potpurri/stepper-driver-thing-test-board/Stupid-stepper.kicad_pcb

## KiCad design Stupid-stepper.kicad_pcb (2026-04-08)

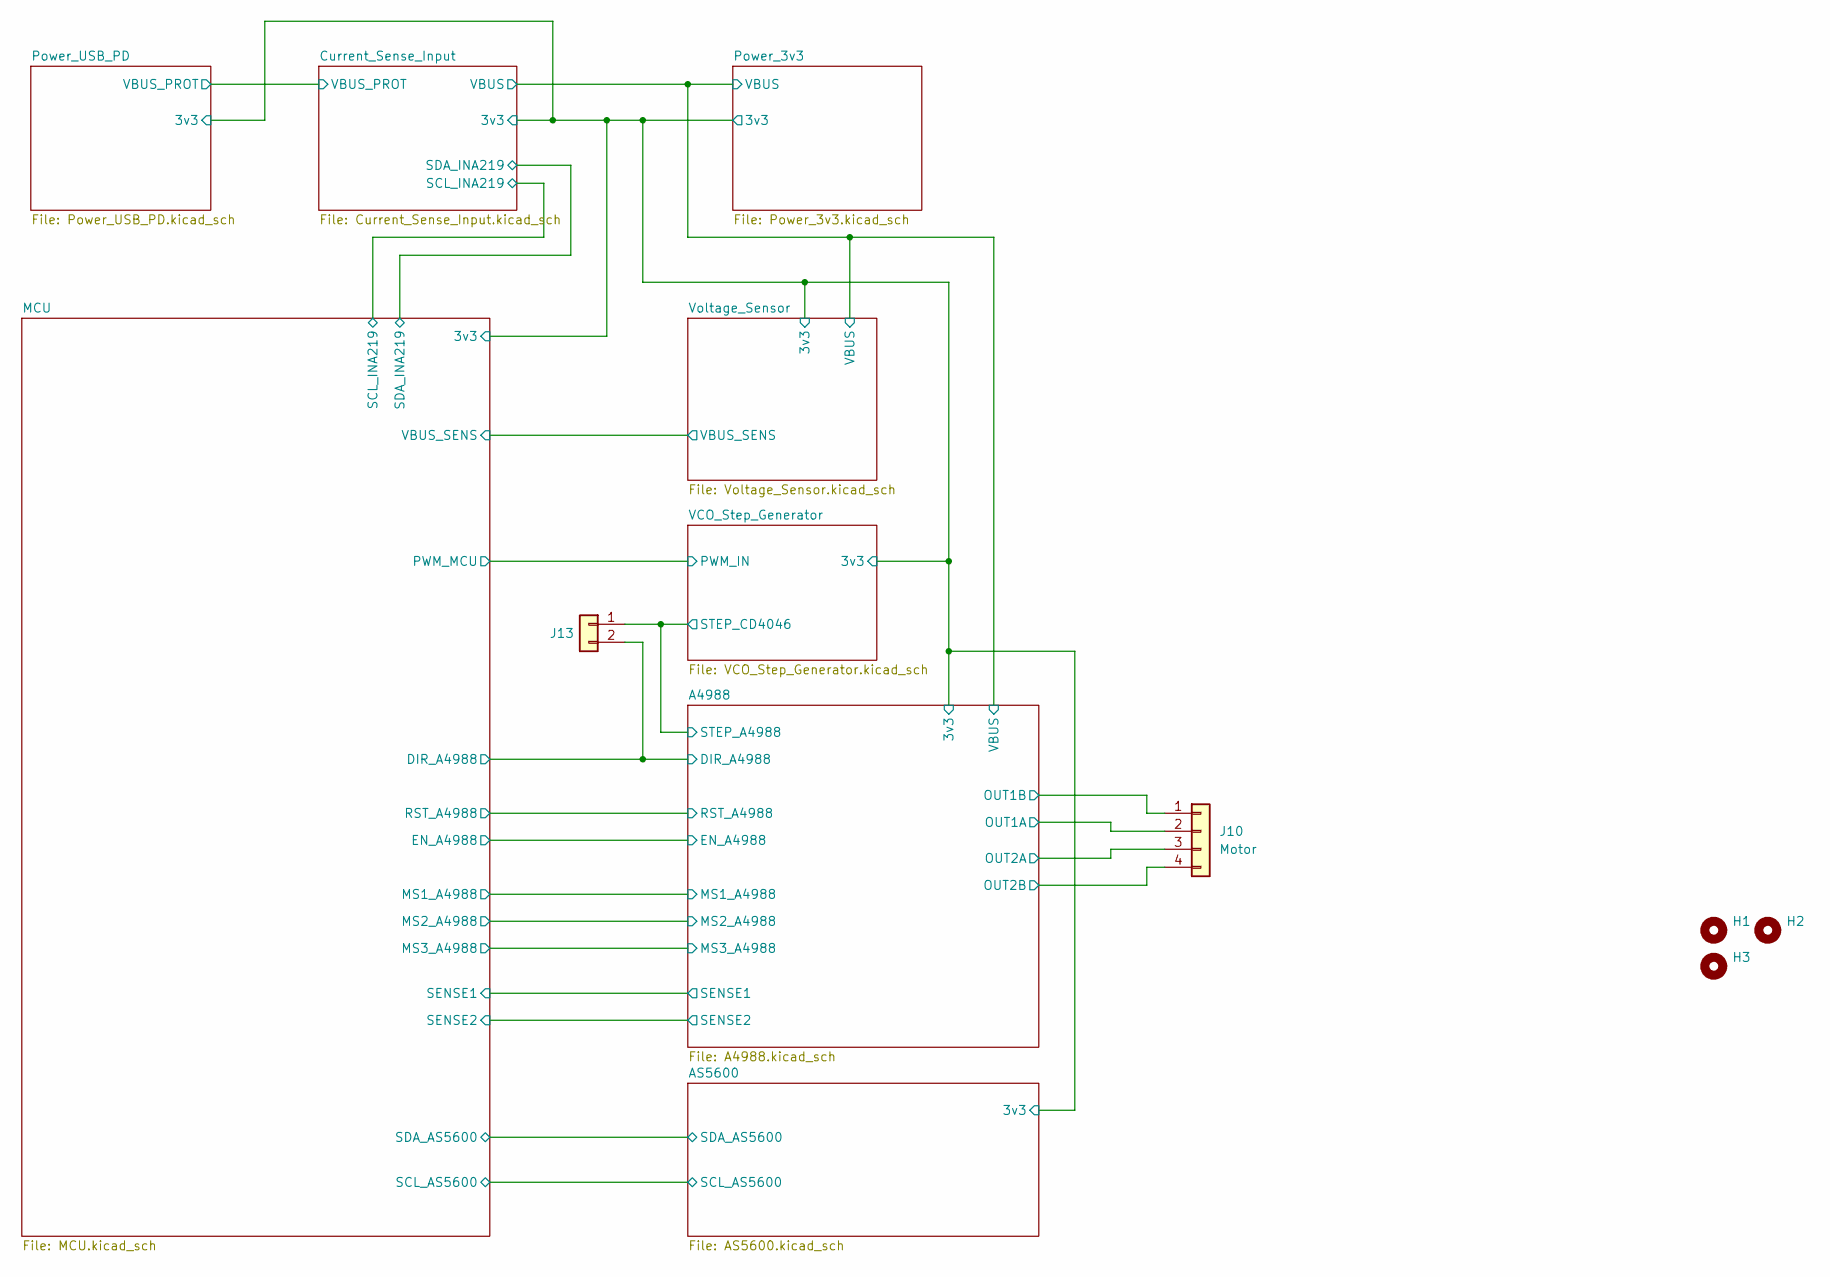
[picture p1: schematic Stupid-stepper.kicad_sch]

Parts:
H1, H2, H3: MountingHole; MountingHole_3.2mm_M3_DIN965_Pad_TopBottom
J10: Motor; JST_PH_B4B-PH-K_1x04_P2.00mm_Vertical
J13: Conn_01x02; PinHeader_1x02_P2.54mm_Vertical

Connections:
/A4988/DIR_A4988: J13.2; also elsewhere on the board
/A4988/OUT1A: J10.2; also elsewhere on the board
/A4988/OUT1B: J10.1; also elsewhere on the board
/A4988/OUT2A: J10.3; also elsewhere on the board
/A4988/OUT2B: J10.4; also elsewhere on the board
/A4988/STEP_A4988: J13.1; also elsewhere on the board

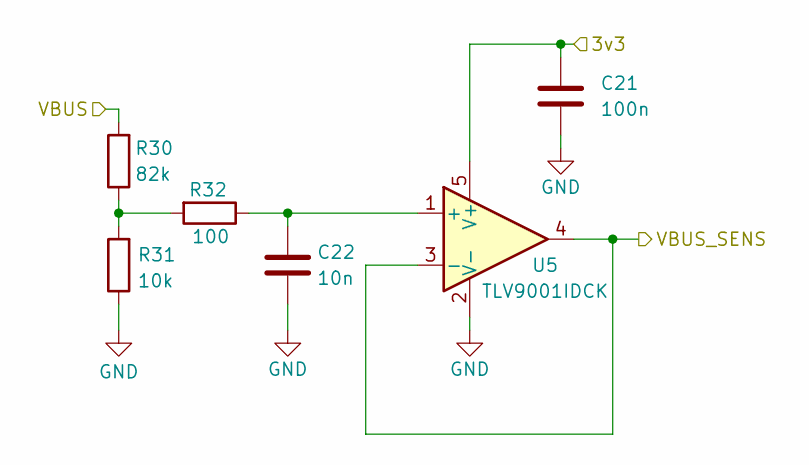
[picture p2: schematic Voltage_Sensor.kicad_sch]

Parts:
C21: 100n; C_0603_1608Metric
C22: 10n; C_0603_1608Metric
R30: 82k; R_0603_1608Metric
R31: 10k; R_0603_1608Metric
R32: 100; R_0603_1608Metric
U5: TLV9001IDCK; SOT-353_SC-70-5

Connections:
+3.3V: C21.1, U5.5 (V+); also elsewhere on the board
/MCU/VBUS_SENS: U5.3 (-), U5.4; also elsewhere on the board
GND: C21.2, C22.2, R31.1, U5.2 (V-); also elsewhere on the board
unnamed: R30.1, R31.2, R32.2
unnamed: C22.1, R32.1, U5.1 (+)
VBUS: R30.2; also elsewhere on the board

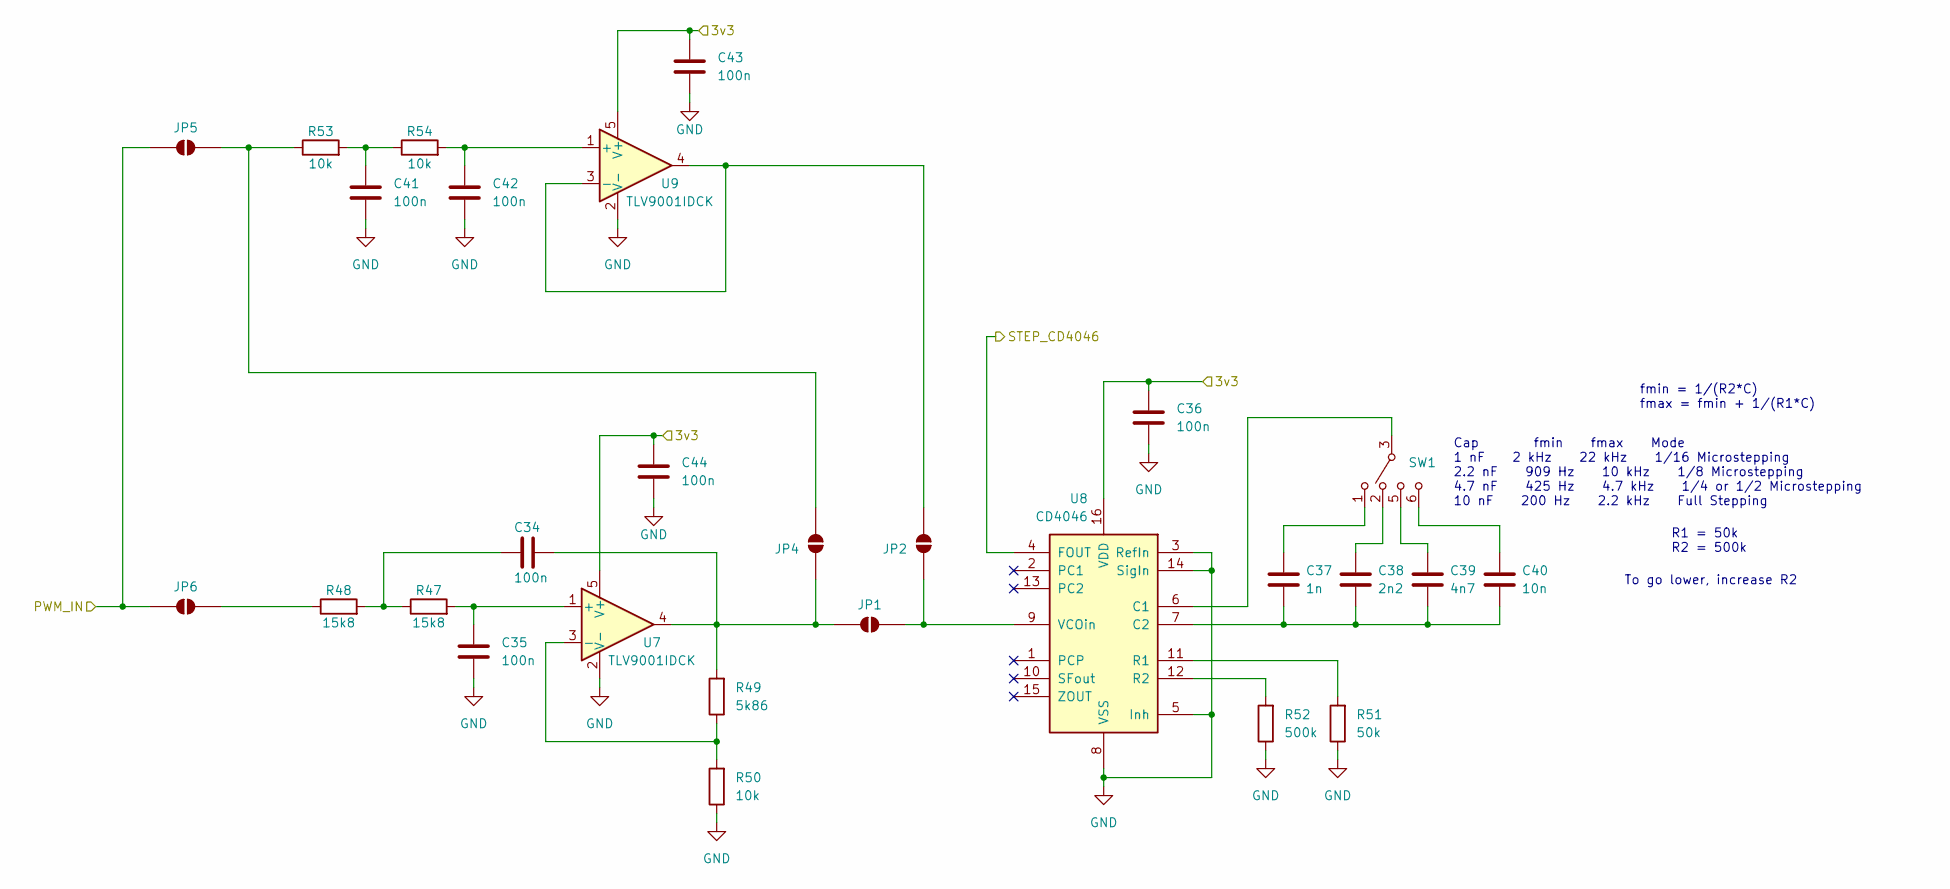
[picture p3: schematic VCO_Step_Generator.kicad_sch]

Parts:
C34, C35, C36, C41, C42, C43, C44: 100n; C_0603_1608Metric
C37: 1n; C_0603_1608Metric
C38: 2n2; C_0603_1608Metric
C39: 4n7; C_0603_1608Metric
C40: 10n; C_0603_1608Metric
JP1, JP2, JP4, JP5, JP6: SolderJumper_2_Open; SolderJumper-2_P1.3mm_Open_RoundedPad1.0x1.5mm
R47, R48: 15k8; R_0603_1608Metric
R49: 5k86; R_0603_1608Metric
R50, R53, R54: 10k; R_0603_1608Metric
R51: 50k; R_0603_1608Metric
R52: 500k; R_0603_1608Metric
SW1: mskt-14c01
U7, U9: TLV9001IDCK; SOT-353_SC-70-5
U8: CD4046; TSSOP-16_4.4x5mm_P0.65mm

Connections:
+3.3V: C36.1, C43.1, C44.1, U7.5 (V+), U8.16 (VDD), U9.5 (V+); also elsewhere on the board
/A4988/STEP_A4988: U8.4 (FOUT); also elsewhere on the board
/MCU/PWM_MCU: JP5.1 (A), JP6.1 (A); also elsewhere on the board
GND: C35.2, C36.2, C41.2, C42.2, C43.2, C44.2, R50.1, R51.1, R52.1, U7.2 (V-), U8.3 (RefIn), U8.5 (Inh), U8.8 (VSS), U8.14 (SigIn), U9.2 (V-); also elsewhere on the board
unnamed: C34.2, R47.1, R48.2
unnamed: C37.1, SW1.1
unnamed: C38.1, SW1.2
unnamed: C39.1, SW1.5
unnamed: C40.1, SW1.6
unnamed: C41.1, R53.2, R54.1
unnamed: C34.1, JP1.1 (A), JP4.2 (B), R49.2, U7.4
unnamed: JP1.2 (B), JP2.2 (B), U8.9 (VCOin)
unnamed: JP2.1 (A), U9.3 (-), U9.4
unnamed: JP4.1 (A), JP5.2 (B), R53.1
unnamed: JP6.2 (B), R48.1
unnamed: C35.1, R47.2, U7.1 (+)
unnamed: R49.1, R50.2, U7.3 (-)
unnamed: SW1.3, SW1.4, U8.6 (C1)
unnamed: C37.2, C38.2, C39.2, C40.2, U8.7 (C2)
unnamed: R51.2, U8.11 (R1)
unnamed: R52.2, U8.12 (R2)
unnamed: C42.1, R54.2, U9.1 (+)

Notes on the sheet:
R1 = 50k R2 = 500k
fmin = 1/(R2*C) fmax = fmin + 1/(R1*C)
To go lower, increase R2
Cap fmin fmax Mode 1 nF 2 kHz 22 kHz 1/16 Microstepping 2.2 nF 909 Hz 10 kHz 1/8 Microstepping 4.7 nF 425 Hz 4.7 kHz 1/4 or 1/2 Microstepping 10 nF 200 Hz 2.2 kHz Full Stepping

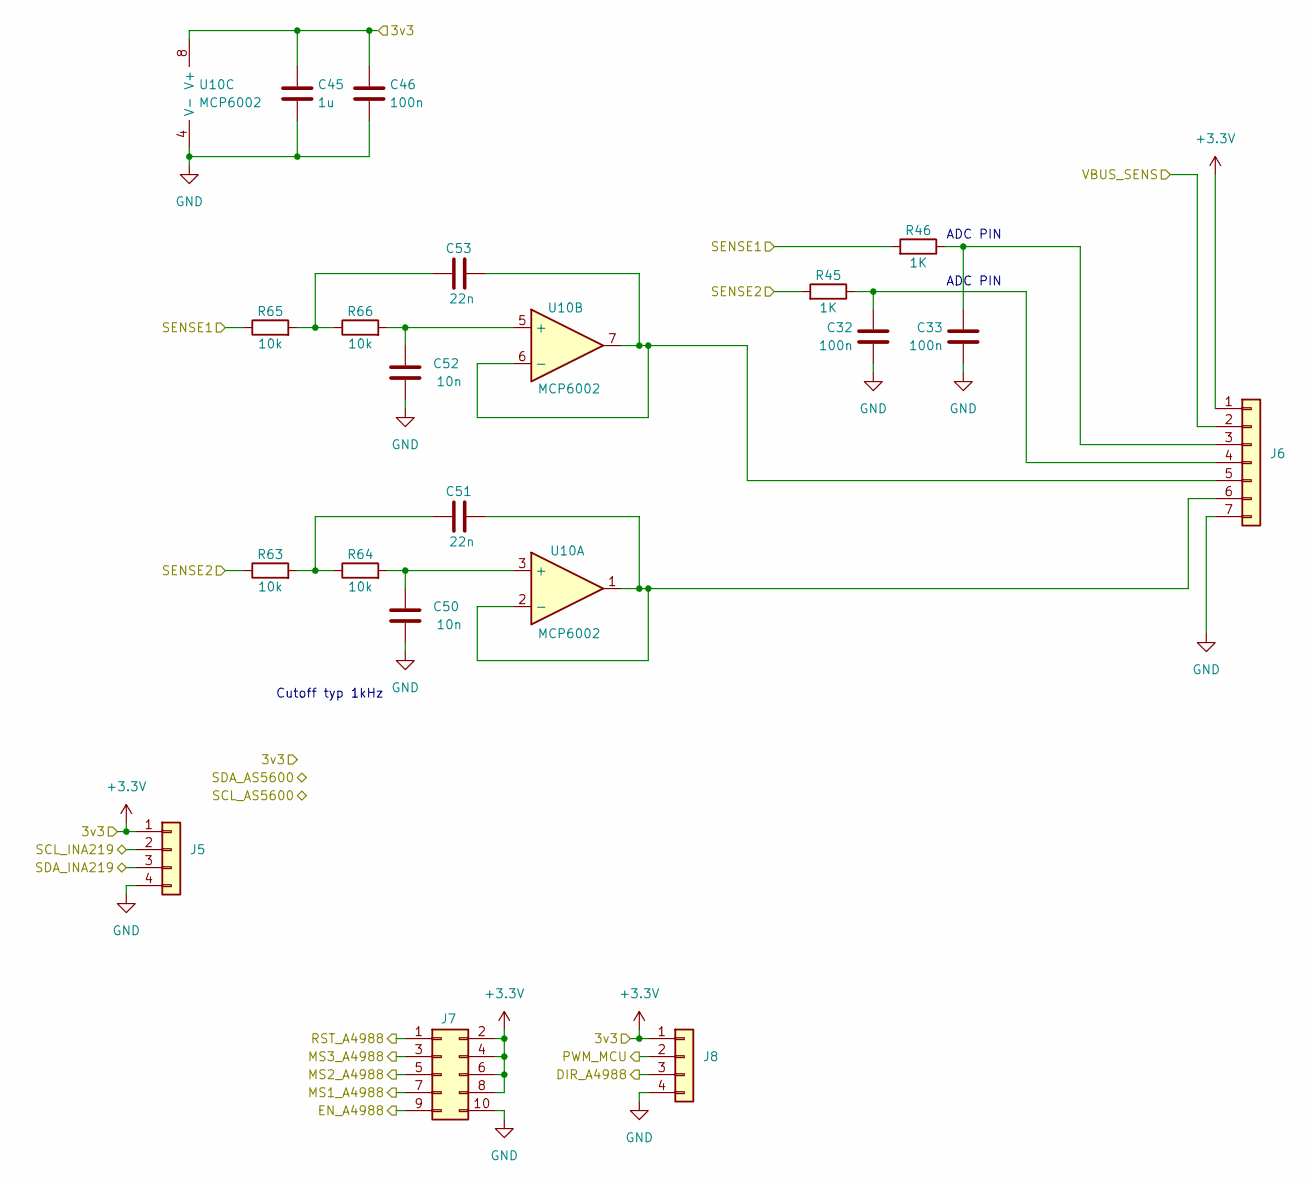
[picture p4: schematic MCU.kicad_sch]

Parts:
C32, C33, C46: 100n; C_0603_1608Metric
C45: 1u; C_0603_1608Metric
C50, C52: 10n; C_0603_1608Metric
C51, C53: 22n; C_0603_1608Metric
J5, J8: Conn_01x04; PinHeader_1x04_P2.54mm_Vertical
J6: Conn_01x07; PinHeader_1x07_P2.54mm_Vertical
J7: Conn_02x05_Odd_Even; PinHeader_2x05_P2.54mm_Vertical
R45, R46: 1K; R_0603_1608Metric
R63, R64, R65, R66: 10k; R_0603_1608Metric
U10:  MCP6002; SOIC-8_3.9x4.9mm_P1.27mm

Connections:
+3.3V: C45.1, C46.1, J5.1, J6.1, J7.2, J7.4, J7.6, J7.8, J8.1, U10.8 (V+); also elsewhere on the board
/A4988/DIR_A4988: J8.3; also elsewhere on the board
/A4988/EN_A4988: J7.9; also elsewhere on the board
/A4988/MS1_A4988: J7.7; also elsewhere on the board
/A4988/MS2_A4988: J7.5; also elsewhere on the board
/A4988/MS3_A4988: J7.3; also elsewhere on the board
/A4988/RST_A4988: J7.1; also elsewhere on the board
/A4988/SENSE1: R46.2, R65.1; also elsewhere on the board
/A4988/SENSE2: R45.2, R63.1; also elsewhere on the board
/Current_Sense_Input/SCL_INA219: J5.2; also elsewhere on the board
/Current_Sense_Input/SDA_INA219: J5.3; also elsewhere on the board
/MCU/PWM_MCU: J8.2; also elsewhere on the board
/MCU/VBUS_SENS: J6.2; also elsewhere on the board
GND: C32.2, C33.2, C45.2, C46.2, C50.2, C52.2, J5.4, J6.7, J7.10, J8.4, U10.4 (V-); also elsewhere on the board
unnamed: C51.2, R63.2, R64.1
unnamed: C53.2, R65.2, R66.1
unnamed: C33.1, J6.3, R46.1
unnamed: C32.1, J6.4, R45.1
unnamed: C53.1, J6.5, U10.6 (-), U10.7
unnamed: C51.1, J6.6, U10.1, U10.2 (-)
unnamed: C50.1, R64.2, U10.3 (+)
unnamed: C52.1, R66.2, U10.5 (+)

Notes on the sheet:
ADC PIN
Cutoff typ 1kHz

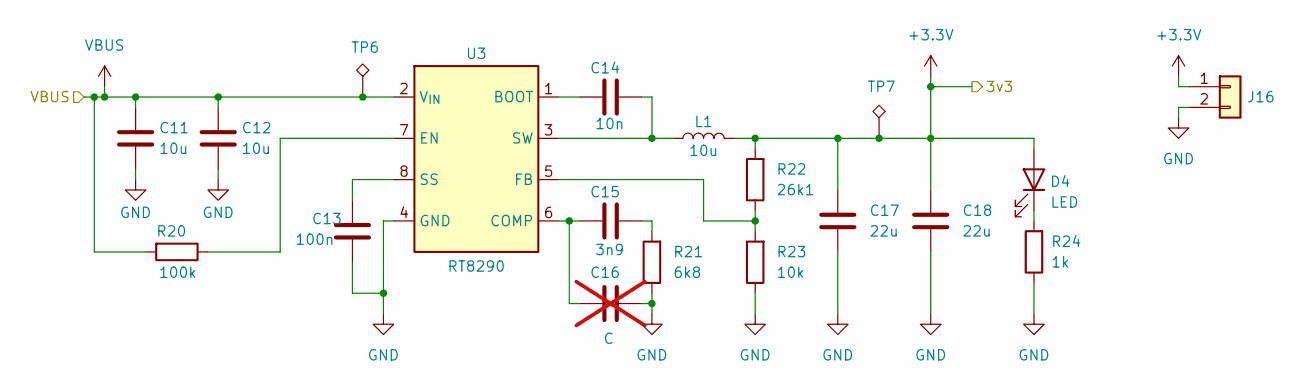
[picture p5: schematic Power_3v3.kicad_sch]

Parts:
C11, C12: 10u; C_1206_3216Metric
C13: 100n; C_0603_1608Metric
C14: 10n; C_0603_1608Metric
C15: 3n9; C_0603_1608Metric
C16: C; C_0603_1608Metric; not fitted
C17, C18: 22u; C_1206_3216Metric
D4: LED; LED_0805_2012Metric
J16: Conn_01x02; PinHeader_1x02_P2.54mm_Vertical
L1: 10u; L_APV_ANR5020
R20: 100k; R_0603_1608Metric
R21: 6k8; R_0603_1608Metric
R22: 26k1; R_0603_1608Metric
R23: 10k; R_0603_1608Metric
R24: 1k; R_0603_1608Metric
TP6, TP7: TestPoint_Alt; TestPoint_Pad_D1.0mm
U3: RT8290; Texas_HSOP-8-1EP_3.9x4.9mm_P1.27mm

Connections:
+3.3V: C17.1, C18.1, D4.2 (A), J16.1, L1.2, R22.2, TP7.1 (1_1); also elsewhere on the board
GND: C11.2, C12.2, C13.2, C16.2, C17.2, C18.2, J16.2, R21.1, R23.1, R24.1, U3.4 (GND), U3.9 (GND); also elsewhere on the board
unnamed: C15.2, R21.2
unnamed: D4.1 (K), R24.2
unnamed: C14.1, U3.1 (BOOT)
unnamed: C15.1, C16.1, U3.6 (COMP)
unnamed: R20.1, U3.7 (EN)
unnamed: R22.1, R23.2, U3.5 (FB)
unnamed: C13.1, U3.8 (SS)
unnamed: C14.2, L1.1, U3.3 (SW)
VBUS: C11.1, C12.1, R20.2, TP6.1 (1_1), U3.2 (V_{IN}); also elsewhere on the board

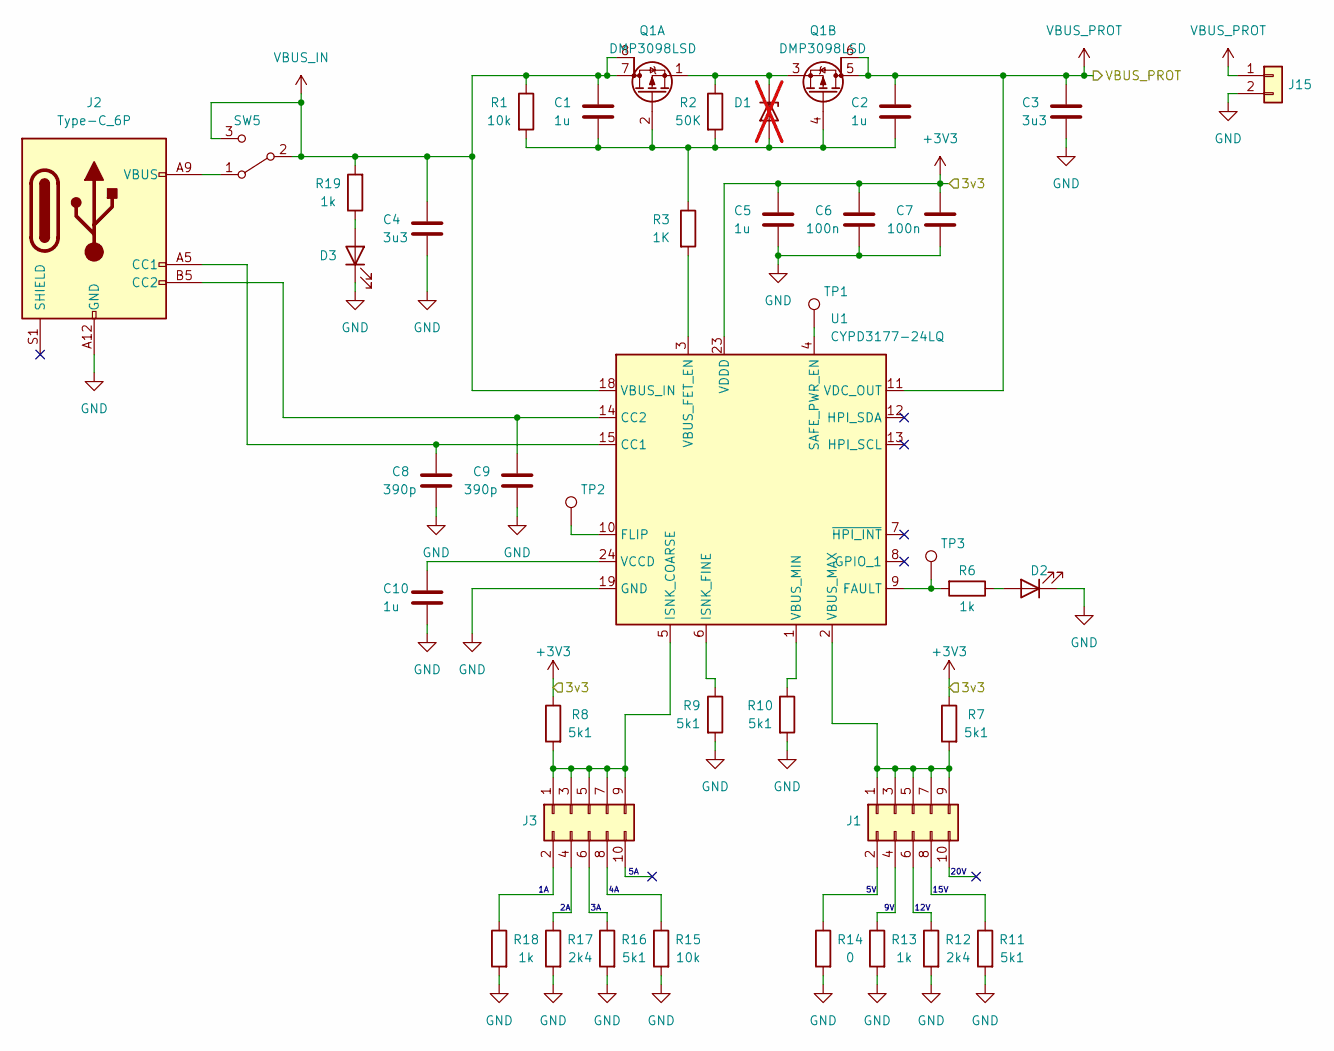
[picture p6: schematic Power_USB_PD.kicad_sch]

Parts:
C1, C2, C5, C10: 1u; C_0805_2012Metric_Pad1.18x1.45mm_HandSolder
C3, C4: 3u3; C_0805_2012Metric_Pad1.18x1.45mm_HandSolder
C6, C7: 100n; C_0603_1608Metric_Pad1.08x0.95mm_HandSolder
C8, C9: 390p; C_0603_1608Metric_Pad1.08x0.95mm_HandSolder
D1: D_Zener; D_DO-35_SOD27_P7.62mm_Horizontal; not fitted
D2, D3: LED; LED_0805_2012Metric
J1, J3: Conn_02x05_Odd_Even; PinHeader_2x05_P2.54mm_Vertical
J2: Type-C_6P; USB_C_Receptacle_HRO_TYPE-C-31-M-17
J15: Conn_01x02; PinHeader_1x02_P2.54mm_Vertical
Q1: DMP3098LSD; SOIC-8-1EP_3.9x4.9mm_P1.27mm_EP2.29x3mm
R1, R15: 10k; R_0603_1608Metric
R2: 50K; R_0603_1608Metric
R3: 1K; R_0603_1608Metric
R6, R13, R18, R19: 1k; R_0603_1608Metric
R7, R8, R9, R10, R11, R16: 5k1; R_0603_1608Metric
R12, R17: 2k4; R_0603_1608Metric
R14: 0; R_0603_1608Metric
SW5: SW_SPDT; Schiebeschalter SS-12D00
TP1, TP2, TP3: TestPoint; TestPoint_Pad_1.0x1.0mm
U1: CYPD3177-24LQ; QFN-24-1EP_4x4mm_P0.5mm_EP2.75x2.75mm_ThermalVias

Connections:
+3.3V: C5.1, C6.1, C7.1, R7.1, R8.1, U1.23 (VDDD); also elsewhere on the board
GND: C3.2, C4.2, C5.2, C6.2, C7.2, C8.2, C9.2, C10.2, D2.1 (K), D3.1 (K), J2.A12 (GND), J2.B12 (GND), J15.2, R9.2, R10.2, R11.2, R12.2, R13.2, R14.2, R15.2, R16.2, R17.2, R18.2, U1.19 (GND), U1.22 (GND), U1.25 (GND); also elsewhere on the board
unnamed: C1.2, C2.2, D1.2 (A), Q1.2 (G), Q1.4 (G), R1.2, R2.2, R3.1
unnamed: D1.1 (K), Q1.1 (S), Q1.3 (S), R2.1
unnamed: D2.2 (A), R6.1
unnamed: D3.2 (A), R19.1
unnamed: J1.1, J1.3, J1.5, J1.7, J1.9, R7.2, U1.2 (VBUS_MAX)
unnamed: J1.2, R14.1
unnamed: J1.4, R13.1
unnamed: J1.6, R12.1
unnamed: J1.8, R11.1
unnamed: C8.1, J2.A5 (CC1), U1.15 (CC1)
unnamed: C9.1, J2.B5 (CC2), U1.14 (CC2)
unnamed: J3.1, J3.3, J3.5, J3.7, J3.9, R8.2, U1.5 (ISNK_COARSE)
unnamed: J3.2, R18.1
unnamed: J3.4, R17.1
unnamed: J3.6, R16.1
unnamed: J3.8, R15.1
unnamed: J2.A9 (VBUS), J2.B9 (VBUS), SW5.1 (A)
unnamed: R6.2, TP3.1 (1_1), U1.9 (FAULT)
unnamed: TP2.1 (1_1), U1.10 (FLIP)
unnamed: R9.1, U1.6 (ISNK_FINE)
unnamed: TP1.1 (1_1), U1.4 (SAFE_PWR_EN)
unnamed: R3.2, U1.3 (VBUS_FET_EN)
unnamed: R10.1, U1.1 (VBUS_MIN)
unnamed: C10.1, U1.24 (VCCD)
VBUS_IN: C1.1, C4.1, Q1.7 (D), Q1.8 (G), R1.1, R19.2, SW5.2 (B), SW5.3 (C), U1.18 (VBUS_IN)
VBUS_PROT: C2.1, C3.1, J15.1, Q1.5 (D), Q1.6 (G), U1.11 (VDC_OUT); also elsewhere on the board

Notes on the sheet:
15V
20V
12V

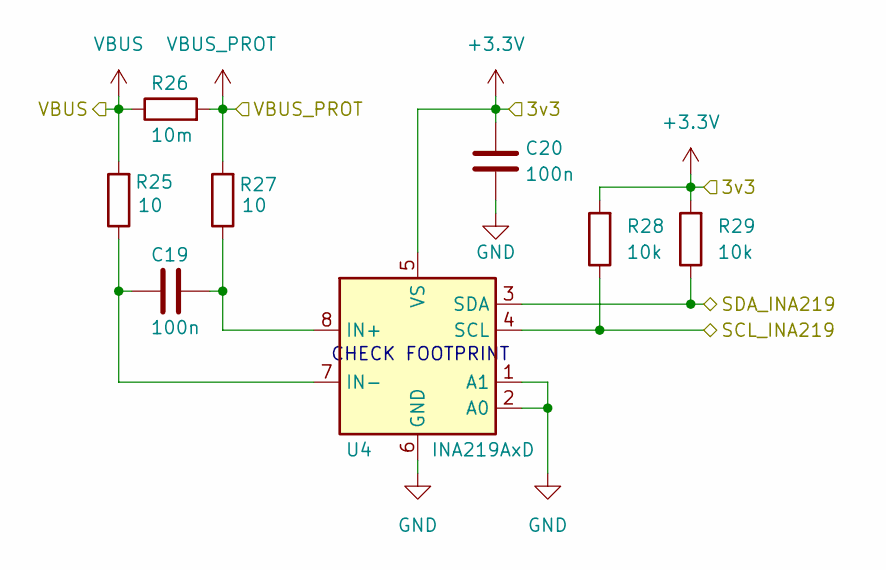
[picture p7: schematic Current_Sense_Input.kicad_sch]

Parts:
C19, C20: 100n; C_0603_1608Metric
R25, R27: 10; R_0603_1608Metric
R26: 10m; R_2512_6332Metric
R28, R29: 10k; R_0603_1608Metric
U4: INA219AxD; SOIC-8_3.9x4.9mm_P1.27mm

Connections:
+3.3V: C20.1, R28.2, R29.2, U4.5 (VS); also elsewhere on the board
/Current_Sense_Input/SCL_INA219: R28.1, U4.4 (SCL); also elsewhere on the board
/Current_Sense_Input/SDA_INA219: R29.1, U4.3 (SDA); also elsewhere on the board
GND: C20.2, U4.1 (A1), U4.2 (A0), U4.6 (GND); also elsewhere on the board
unnamed: C19.1, R27.1, U4.8 (IN+)
unnamed: C19.2, R25.1, U4.7 (IN-)
VBUS: R25.2, R26.1; also elsewhere on the board
VBUS_PROT: R26.2, R27.2; also elsewhere on the board

Notes on the sheet:
CHECK FOOTPRINT

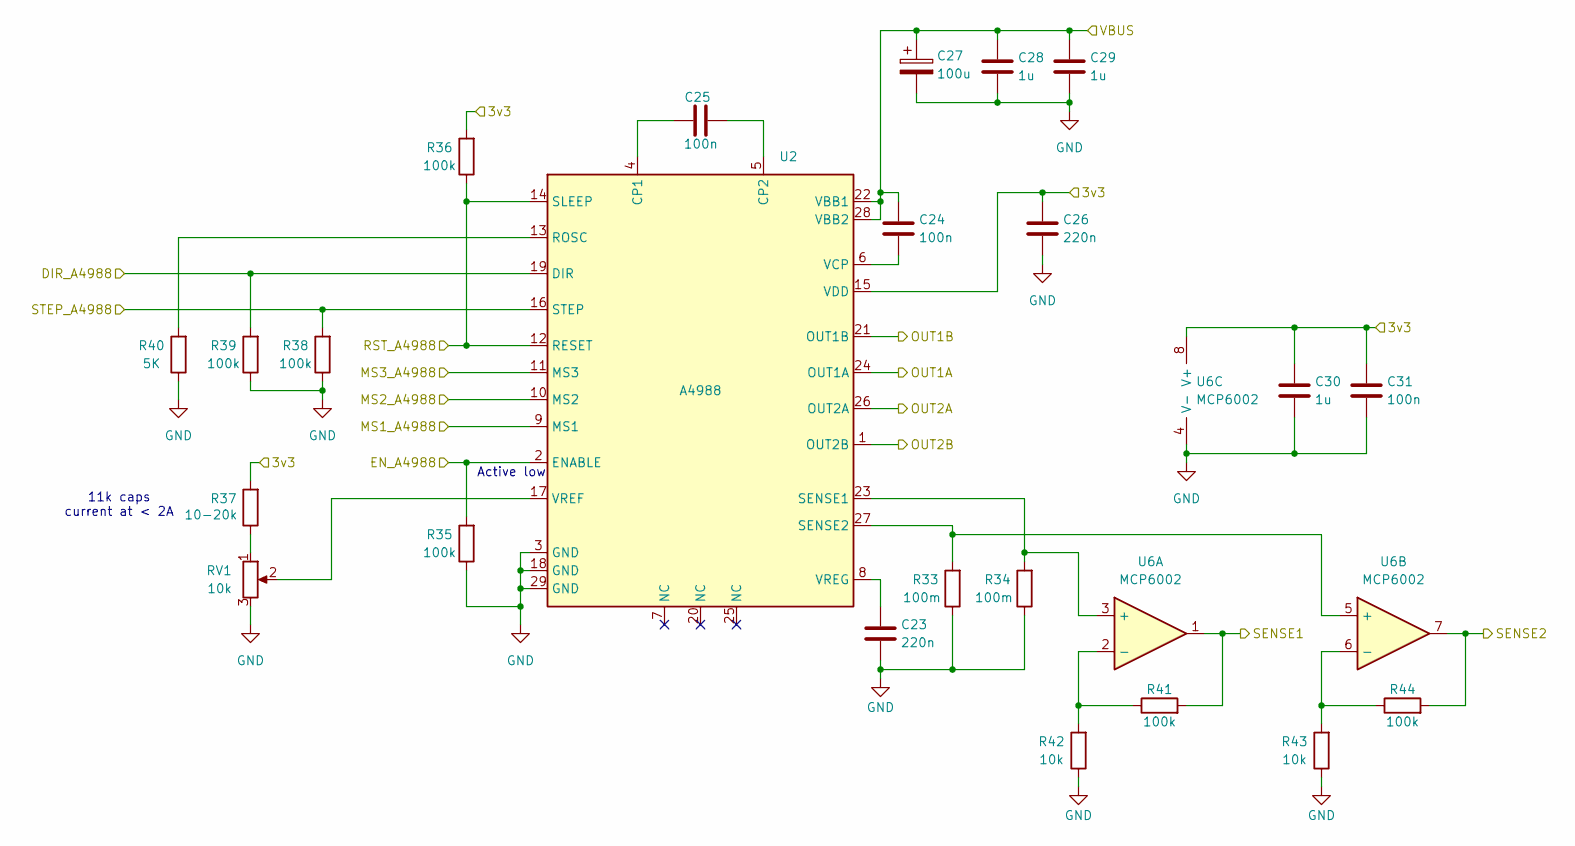
[picture p8: schematic A4988.kicad_sch]

Parts:
C23, C26: 220n; C_0603_1608Metric
C24, C25, C31: 100n; C_0603_1608Metric
C27: 100u; CP_Elec_8x10.5
C28, C29, C30: 1u; C_0603_1608Metric
R33, R34: 100m; R_1206_3216Metric
R35, R36, R38, R39, R41, R44: 100k; R_0603_1608Metric
R37: 10-20k; R_0603_1608Metric
R40: 5K; R_0603_1608Metric
R42, R43: 10k; R_0603_1608Metric
RV1: 10k; Potentiometer_Bourns_TC33X_Vertical
U2: A4988; VQFN-28-1EP_5x5mm_P0.5mm_EP3.25x3.25mm_ThermalVias
U6:  MCP6002; SOIC-8_3.9x4.9mm_P1.27mm

Connections:
+3.3V: C26.1, C30.1, C31.1, R36.2, R37.2, U2.15 (VDD), U6.8 (V+); also elsewhere on the board
/A4988/DIR_A4988: R39.2, U2.19 (DIR); also elsewhere on the board
/A4988/EN_A4988: R35.2, U2.2 (ENABLE); also elsewhere on the board
/A4988/MS1_A4988: U2.9 (MS1); also elsewhere on the board
/A4988/MS2_A4988: U2.10 (MS2); also elsewhere on the board
/A4988/MS3_A4988: U2.11 (MS3); also elsewhere on the board
/A4988/OUT1A: U2.24 (OUT1A); also elsewhere on the board
/A4988/OUT1B: U2.21 (OUT1B); also elsewhere on the board
/A4988/OUT2A: U2.26 (OUT2A); also elsewhere on the board
/A4988/OUT2B: U2.1 (OUT2B); also elsewhere on the board
/A4988/RST_A4988: R36.1, U2.12 (RESET), U2.14 (SLEEP); also elsewhere on the board
/A4988/SENSE1: R41.2, U6.1; also elsewhere on the board
/A4988/SENSE2: R44.2, U6.7; also elsewhere on the board
/A4988/STEP_A4988: R38.2, U2.16 (STEP); also elsewhere on the board
GND: C23.2, C26.2, C27.2, C28.2, C29.2, C30.2, C31.2, R33.1, R34.1, R35.1, R38.1, R39.1, R40.1, R42.1, R43.1, RV1.3, U2.3 (GND), U2.18 (GND), U2.29 (GND), U6.4 (V-); also elsewhere on the board
unnamed: R37.1, RV1.1
unnamed: C25.1, U2.4 (CP1)
unnamed: C25.2, U2.5 (CP2)
unnamed: R40.2, U2.13 (ROSC)
unnamed: R34.2, U2.23 (SENSE1), U6.3 (+)
unnamed: R33.2, U2.27 (SENSE2), U6.5 (+)
unnamed: C24.2, U2.6 (VCP)
unnamed: RV1.2, U2.17 (VREF)
unnamed: C23.1, U2.8 (VREG)
unnamed: R41.1, R42.2, U6.2 (-)
unnamed: R43.2, R44.1, U6.6 (-)
VBUS: C24.1, C27.1, C28.1, C29.1, U2.22 (VBB1), U2.28 (VBB2); also elsewhere on the board

Notes on the sheet:
Active low
11k caps current at < 2A

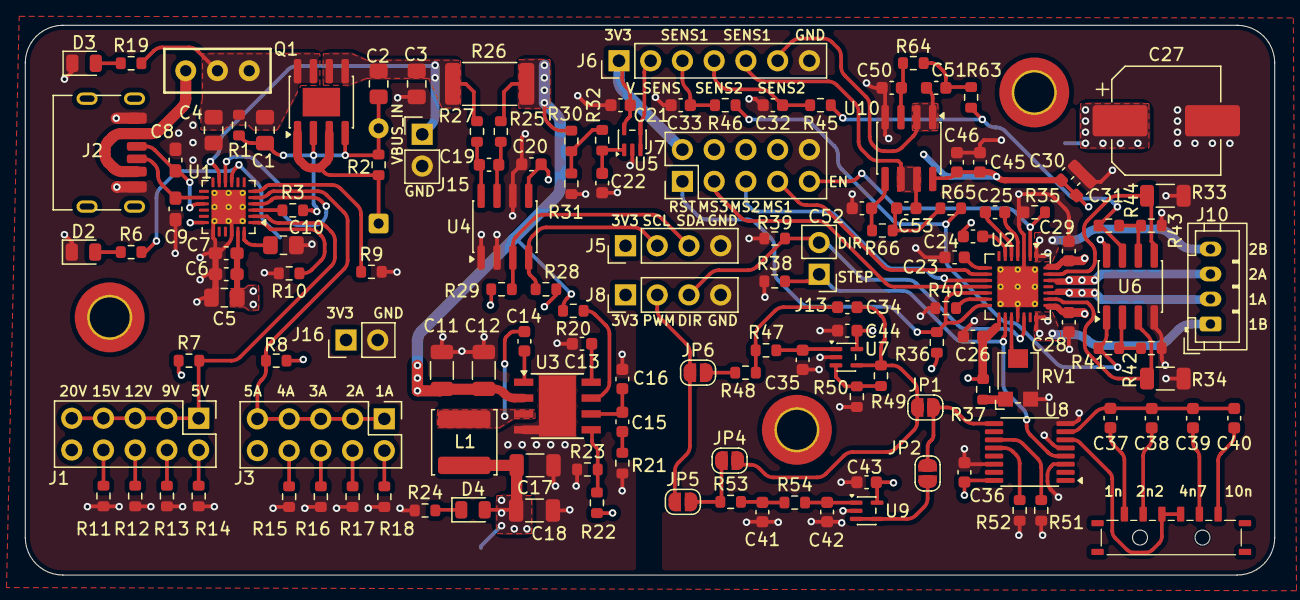
[picture p9: board Stupid-stepper.kicad_pcb from above]

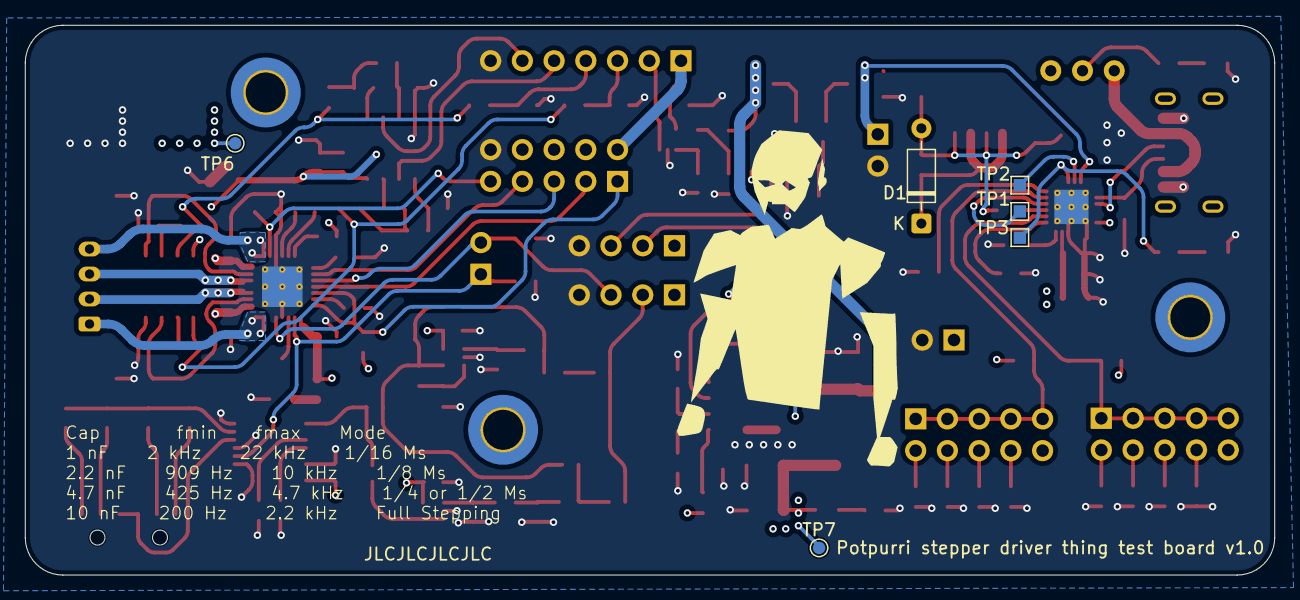
[picture p10: board Stupid-stepper.kicad_pcb from below]

Board: 4 copper layers, 100.0 x 44.0 mm, 149 parts (6 on the bottom side), 95 nets.
